samuelclay/comfortmaps/board/ComfortMaps.brd

## EAGLE design board/ComfortMaps.brd (2020-06-02)

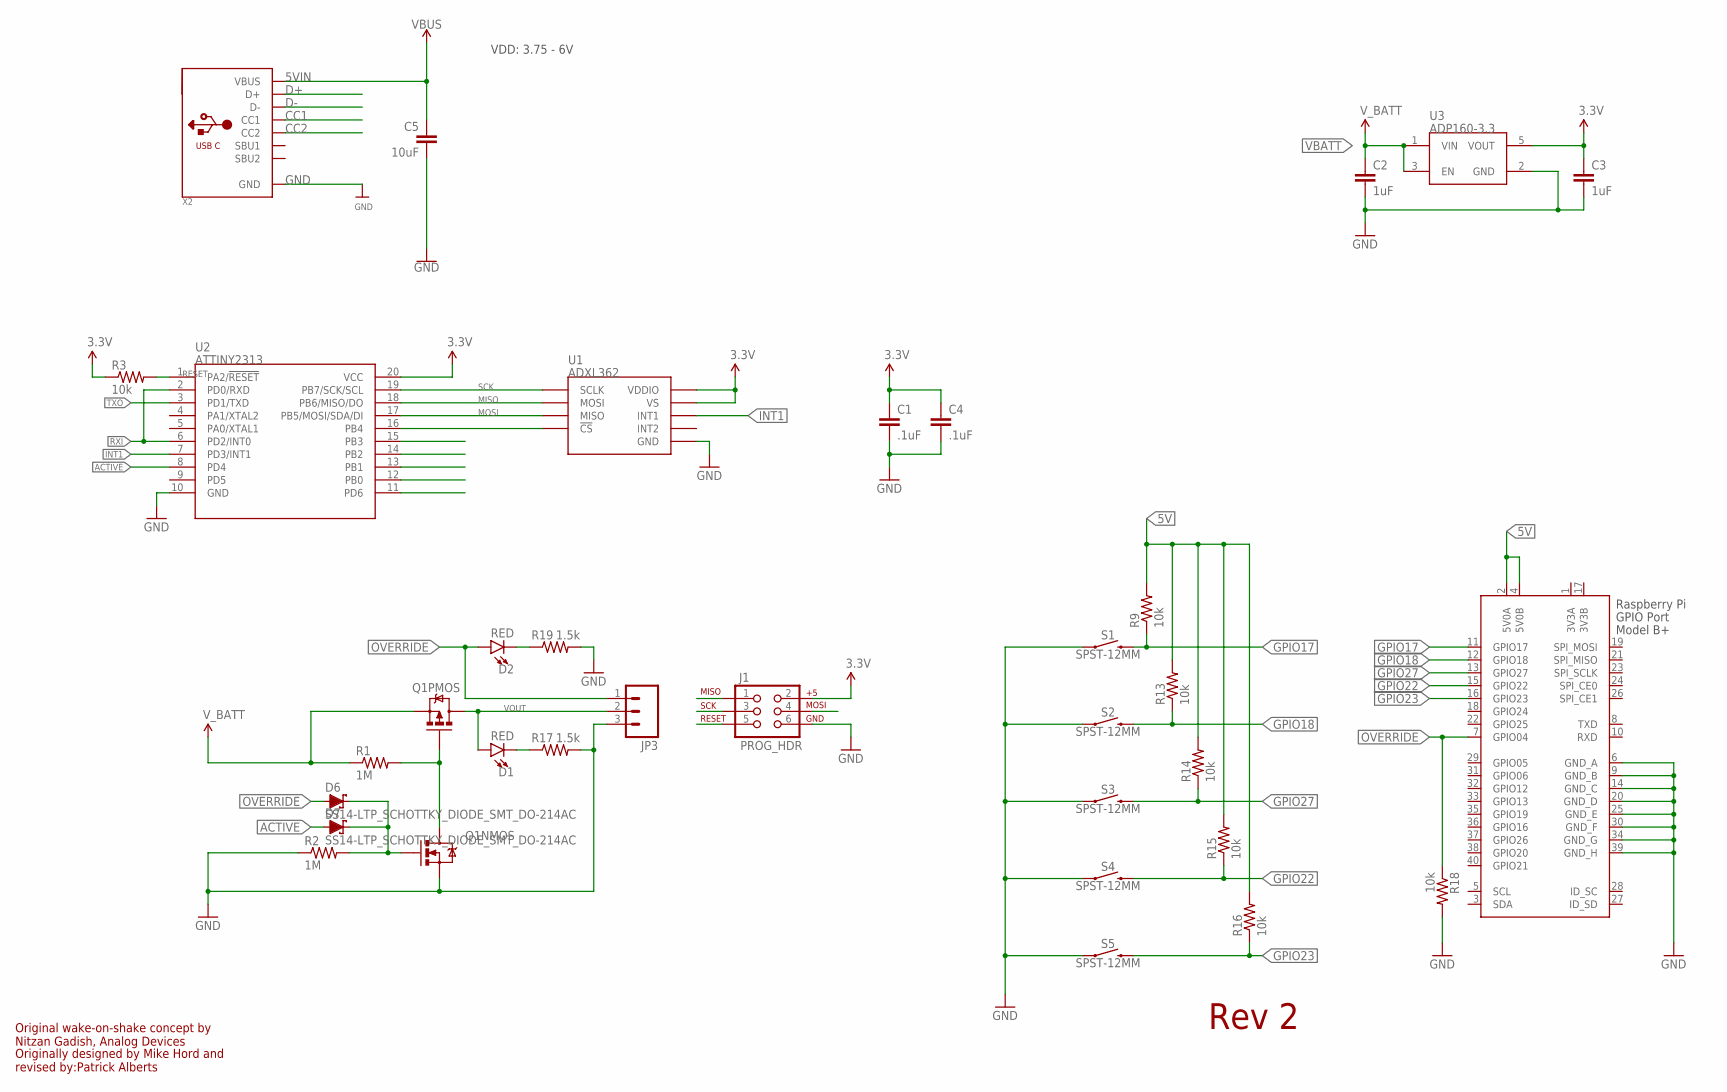
[picture p1: schematic ComfortMaps.sch, sheet 1]

Parts:
C1, C4: .1uF; 0603-CAP
C2, C3: 1uF; 0603-CAP
C5: 10uF; 0603
D1, D2: RED; LED-0603
D6, D7: SS14-LTP_SCHOTTKY_DIODE_SMT_DO-214AC; DO-214AC
J1: PROG_HDR; 2X3
JP3: M03PTH; 1X03
Q1: IRF7509; MSOP8
R1, R2: 1M; 0603-RES
R3, R9, R13, R14, R15, R16, R18: 10k; 0603-RES
R17, R19: 1.5k; 0603
S1, S2, S3, S4, S5: SPST-12MM; TACTILE_SWITCH_SMD_12MM
U1: ADXL362; ADXL362-1:1
U2: ATTINY2313; SOP20W
U3: ADP160-3.3; SOT23-5
X1: RASPI_GPIO_B+#_PIN; RASPI_GPIO_B+_PIN
X2: USB_C; USB_C_CUSB31-CFM2AX-01-X

Connections:
3.3V: C1.1, C3.1, C4.1, J1.2, R3.1, U1.P$1 (VDDIO), U1.P$14 (VS), U2.20 (VCC), U3.5 (VOUT)
3V3A: X1.1 (3V3A)
3V3B: X1.17 (3V3B)
5V: R9.2, R13.2, R14.2, R15.2, R16.2, X1.2 (5V0A), X1.4 (5V0B); also elsewhere on the board
5VIN: C5.1, X2.A4B9 (VBUS), X2.B4A9 (VBUS); also elsewhere on the board
ACTIVE: D7.A, U2.8 (PD4)
CC1: X2.A5 (CC1)
CC2: X2.B5 (CC2)
D+: X2.A6 (D+), X2.B6 (D+)
D-: X2.A7 (D-), X2.B7 (D-)
GND: C1.2, C2.2, C3.2, C4.2, C5.2, J1.6, JP3.3, Q1.1 (S), R2.1, R17.2, R18.2, R19.2, S1.1, S1.2 (1), S2.1, S2.2 (1), S3.1, S3.2 (1), S4.1, S4.2 (1), S5.1, S5.2 (1), U1.P$12 (GND), U1.P$13 (GND), U1.P$16 (GND), U2.10 (GND), U3.2 (GND), X1.6 (GND_A), X1.9 (GND_B), X1.14 (GND_C), X1.20 (GND_D), X1.25 (GND_E), X1.30 (GND_F), X1.34 (GND_G), X1.39 (GND_H), X2.A1B12 (GND), X2.B1A12 (GND); also elsewhere on the board
GPIO17: R9.1, S1.3 (2), S1.4 (2), X1.11 (GPIO17)
GPIO18: R13.1, S2.3 (2), S2.4 (2), X1.12 (GPIO18)
GPIO22: R15.1, S4.3 (2), S4.4 (2), X1.15 (GPIO22)
GPIO23: R16.1, S5.3 (2), S5.4 (2), X1.16 (GPIO23)
GPIO27: R14.1, S3.3 (2), S3.4 (2), X1.13 (GPIO27)
INT1: U1.P$11 (INT1), U2.7 (PD3/INT1)
MISO: J1.1, U1.P$6 (MOSI), U2.18 (PB6/MISO/DO)
MOSI: J1.4, U1.P$7 (MISO), U2.17 (PB5/MOSI/SDA/DI)
unnamed: Q1.4 (G), Q1.7 (D), Q1.8 (D), R1.2
unnamed: D6.C, D7.C, Q1.2 (G), R2.2
unnamed: U1.P$8 (!CS), U2.16 (PB4)
unnamed: D1.C, R17.1
unnamed: D2.C, R19.1
OVERRIDE: D2.A, D6.A, JP3.1, R18.1, X1.7 (GPIO04)
RESET: J1.5, R3.2, U2.1 (PA2/!RESET)
RXI: U2.2 (PD0/RXD), U2.6 (PD2/INT0)
SCK: J1.3, U1.P$4 (SCLK), U2.19 (PB7/SCK/SCL)
TXO: U2.3 (PD1/TXD)
VBATT: C2.1, Q1.3 (S), R1.1, U3.1 (VIN), U3.3 (EN); also elsewhere on the board
VOUT: D1.A, JP3.2, Q1.5 (D), Q1.6 (D)

Notes on the sheet:
Rev 2
Original wake-on-shake concept by Nitzan Gadish, Analog Devices
Originally designed by Mike Hord and revised by:Patrick Alberts
VDD: 3.75 - 6V

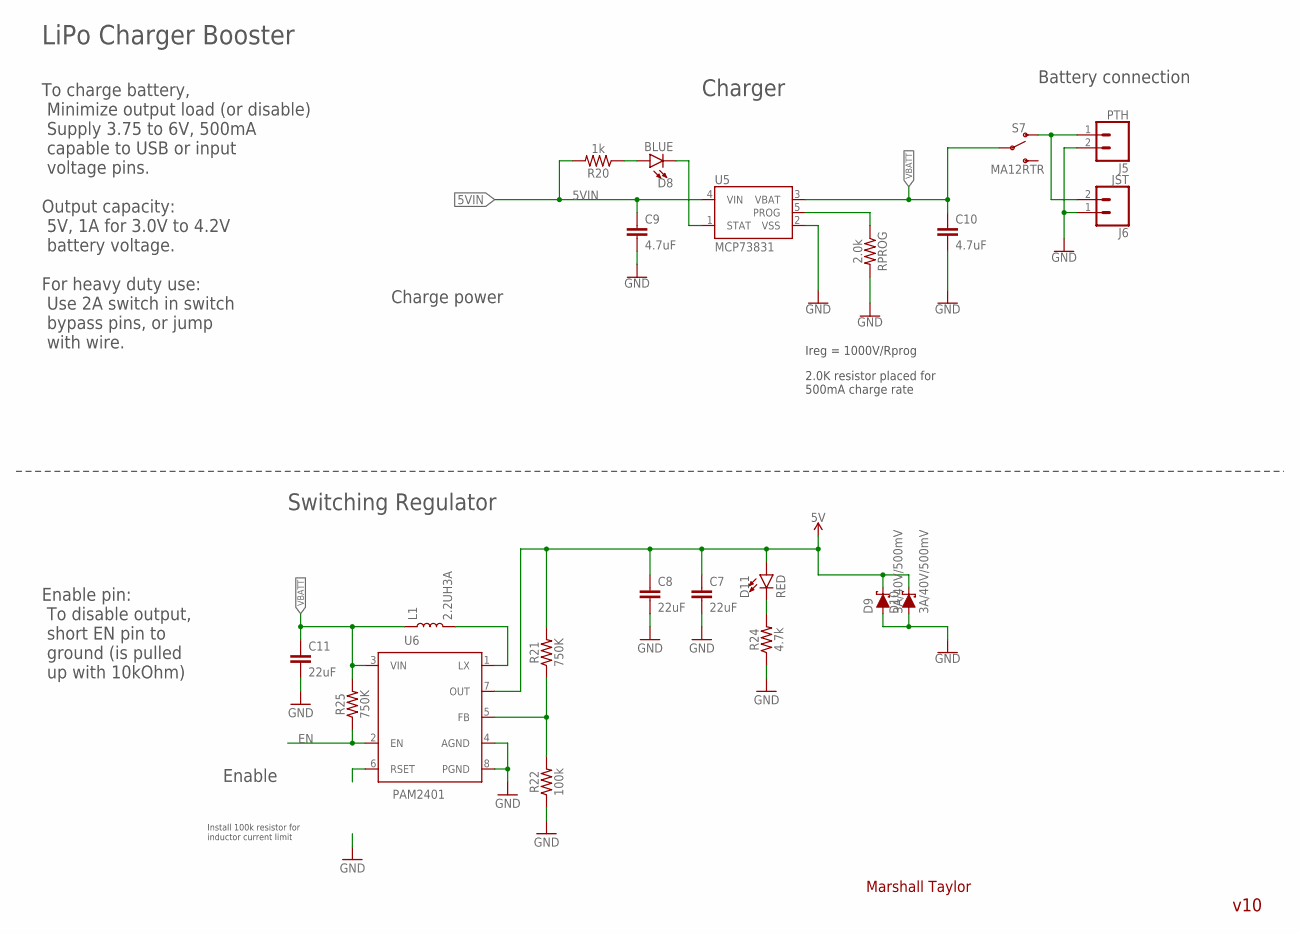
[picture p2: schematic ComfortMaps.sch, sheet 2]

Parts:
C7, C8, C11: 22uF; 0805
C9, C10: 4.7uF; 0603
D8: BLUE; LED-0603
D9, D10: 3A/40V/500mV; SMA-DIODE
D11: RED; LED-0603
J5: PTH; 1X02
J6: JST; JST-2-SMD
L1: 2.2UH3A; INDUCTOR_4X4MM
R20: 1k; 0603
R21, R25: 750K; 0603
R22: 100k; 0603
R24: 4.7k; 0603
RPROG: 2.0k; 0603
S7: MA12RTR; SWITCH_SPST_SMD_A; DIGIKEY 679-1847-1-ND
U5: MCP73831; SOT23-5
U6: PAM2401; MSOP8

Connections:
5V: C7.1, C8.1, D9.C, D10.C, D11.A, R21.2, U6.7 (OUT); also elsewhere on the board
5VIN: C9.1, R20.2, U5.4 (VIN); also elsewhere on the board
EN: R25.1, U6.2 (EN)
GND: C7.2, C8.2, C9.2, C10.2, C11.2, D9.A, D10.A, J5.2, J6.1 (2), R22.1, R24.1, RPROG.2, U5.2 (VSS), U6.4 (AGND), U6.8 (PGND); also elsewhere on the board
unnamed: J5.1, J6.2 (1), S7.1 (O)
unnamed: RPROG.1, U5.5 (PROG)
unnamed: D8.C, U5.1 (STAT)
unnamed: R21.1, R22.2, U6.5 (FB)
unnamed: L1.P$2 (2), U6.1 (LX)
unnamed: D11.C, R24.2
unnamed: D8.A, R20.1
VBATT: C10.1, C11.1, L1.P$1 (1), R25.2, S7.2, U5.3 (VBAT), U6.3 (VIN); also elsewhere on the board

Notes on the sheet:
Charger
Switching Regulator
Marshall Taylor
v10
2.0K resistor placed for 500mA charge rate
Ireg = 1000V/Rprog
To charge battery, Minimize output load (or disable) Supply 3.75 to 6V, 500mA capable to USB or input voltage pins.
Install 100k resistor for inductor current limit
LiPo Charger Booster
Output capacity: 5V, 1A for 3.0V to 4.2V battery voltage.
Enable pin: To disable output, short EN pin to ground (is pulled up with 10kOhm)
Enable
Charge power
Battery connection
For heavy duty use: Use 2A switch in switch bypass pins, or jump with wire.

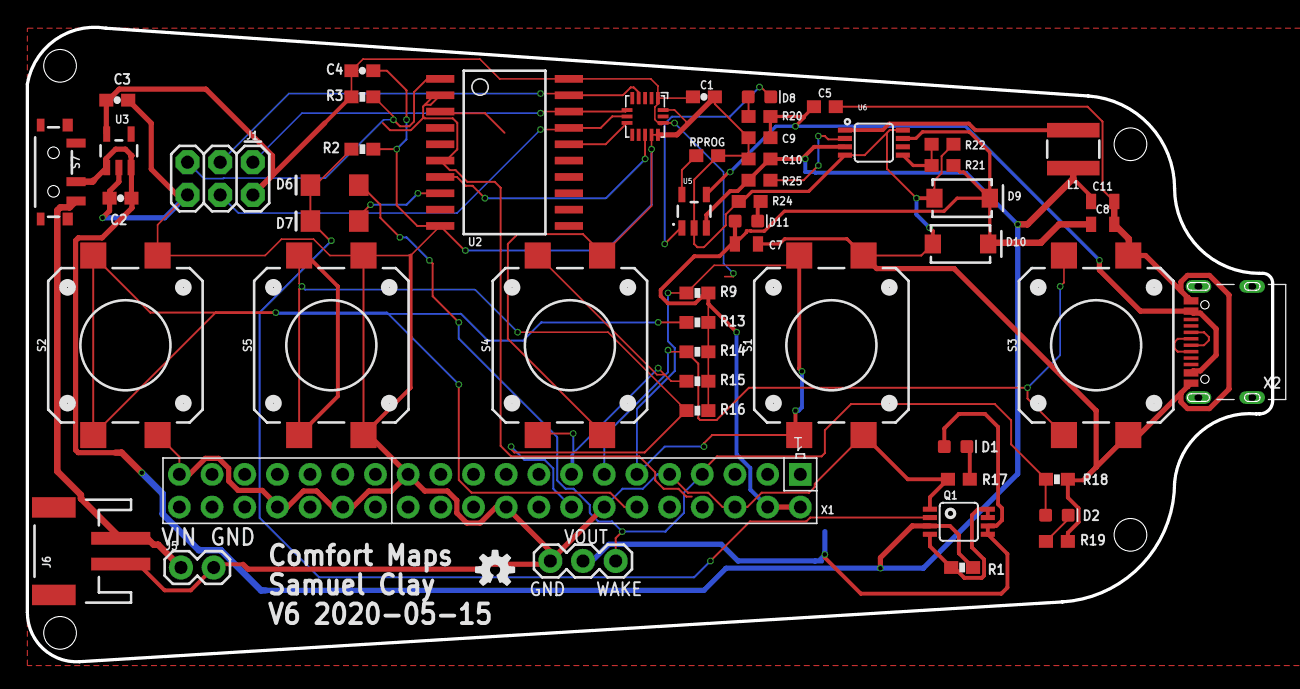
[picture p3: board ComfortMaps.brd from above]

Board: 2 copper layers, 96.8 x 49.3 mm, 55 parts (0 on the bottom side), 34 nets.

Other parts of the board:
U$3: OSHW-LOGO-S
