samuelclay/comfortmaps/(commit log)

2019-10-11 Initial commit, stubbing in snapshots. Needs a login/auth system with just email, then a button UI, then geo.
2019-10-12 Styling rating buttons. Now to hook up snapshots to the DB and add geo.
2019-10-13 Adding gunicorn socket.
2019-11-21 Board design finalized, maybe need to add a buck/boost?
    [ComfortMaps.brd, ComfortMaps.sch]
2019-11-21 Updating board, needs components on digikey.
    [ComfortMaps.brd, ComfortMaps.sch]
2019-11-22 Adding BOM with digikey part numbers for everything. Just need the flex cable and short headers.
2019-11-22 Triangle board.
    [ComfortMaps.brd, ComfortMaps.sch]
2019-12-22 Soldering first board.
    [ComfortMaps.brd, ComfortMaps.sch]
2019-12-24 Prepping for updates to board.
    [ComfortMaps.brd]
2019-12-28 Latest, before upwork.
    [ComfortMaps.brd, ComfortMaps.sch]
2020-01-24 Partial camera JS/node implementation. Needs fixing as well as bluetooth.
2020-01-24 Switching to larger schottke diode.
    [ComfortMaps.brd, ComfortMaps.sch]
2020-01-28 v3 of the board, with new mounting holes and an added LED for V_out.
    [ComfortMaps.brd, ComfortMaps.sch]
2020-01-28 v3 with CAM
    [ComfortMaps.brd, ComfortMaps.csv, PnP_ComfortMaps_back.csv, PnP_ComfortMaps_front.csv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]
2020-02-07 Latest board gerbers.
2020-02-07 Watching buttons.
2020-02-08 Finishing up camera bluetooth image upload. Needs to be faster and terminate correctly, but seems to be working.
2020-02-13 Switching to child process for raspistill command.
2020-02-13 Splitting button and database manager, adding sequelize.
2020-02-13 Fixing button snapshot and stubbing in new snapshot characteristic that notifies of new photo data, leaving photo data to handle uploads.
    [button-manager.js]
2020-02-19 Correct pid/socket fir.
2020-02-19 Creating photos folder if it doesn't exist.
    [button-manager.js]
2020-02-20 Moving gunicorn socket
2020-02-21 Adding camera service for ubuntu.
2020-02-25 Sending batches of photo thumbnails, even as clients reconnect. Somehow sending multiple notifications due to the ending happening multiple times. Need to figure out how to ignore the ending if it's 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
    [button-manager.js]
2020-02-27 Adding heatmaps! Terrible point based but it's a start.
2020-02-28 Enlarging spst button pads and connecting both sides.
    [ComfortMaps.brd, ComfortMaps.sch]
2020-02-28 Beginning v4 of board
    [ComfortMaps.brd]
2020-02-29 v4 of the PCB. Moved around components for better soldering, added Wake/override led, pulldown on wake.
    [ComfortMaps.brd, ComfortMaps.sch]
2020-03-01 Finalizing v4 of board. Moving battery connector so the entire 40 pin connector is solderable and the battery wire no longer gets stuck.
    [ComfortMaps.brd]
2020-03-03 V5 board, with new usb type c connector and lipo charge controller.
    [ComfortMaps.brd, ComfortMaps.csv, ComfortMaps.sch, PnP_ComfortMaps_back.csv, PnP_ComfortMaps_front.csv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]
2020-03-18 Latest v5 cam.
    [ComfortMaps.csv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]
2020-03-22 Adding shutdown.js and handling missing camera.
    [button-manager.js]
2020-03-26 Updating camera map
2020-03-27 Stubbing in serial reader, which is now unnecessary due to wake on shake checking AWAKE signal from IMU.
2020-03-28 Updating to v5
    [ComfortMaps.csv]
2020-04-06 Displaying correct data. Now to add scrolling and interactivity. First, interactivity with hovering over active snapshots and then filtering snapshots with a segmented control.
2020-04-08 Saving photo width in case I ever change it. Probably should have done this then but who knows.
2020-04-09 Adding scrollspy. Needs filter controls.
2020-04-11 Updating favicon, adding buttons, styling text, stubbing in snapshot photo. Needs activation with vuejs. Then filters.
2020-04-13 Adding dropdown, moving snapshot photo around. Needs filters hooked up to scroll events and the navbar.
2020-04-13 Moving around the snapshot photo. Needs filtering.
2020-04-13 Added filters. Would be nice to transition between them which might mean splitting up ratings into separate layers.
2020-04-14 Fixing filter buttons.
2020-04-21 Moving ratings filter into filter dropdown. Need to add date filter and personal filter. Also needs auth.
2020-04-21 New filter dropdown icon.
2020-04-22 Refactoring filters
2020-04-22 Adding ownership filter. Refactoring filters. Adding email hash for ownership.
2020-04-22 Updating icons and adding text to filter controls.
2020-05-03 Finished text. Also indicator now kinda works. Needs fixing. Also needs a live driver with dynamic flying
2020-05-04 Moving back to older lipo charger.
    [ComfortMaps.brd, ComfortMaps.sch]
2020-05-05 Adding faster wakeup pin that runs much quicker.
2020-05-05 Adding status bar to app to show camera.
2020-06-02 v6 board
    [ComfortMaps.brd, ComfortMaps.sch]
